NanoPenguin/hydrabus-usb-c/hardware/HydraBus_1_0_Rev1_4_Kicad_USBC/HydraBus.kicad_pcb

## KiCad design hardware/HydraBus_1_0_Rev1_4_Kicad_USBC/HydraBus.kicad_pcb (2023-07-11)

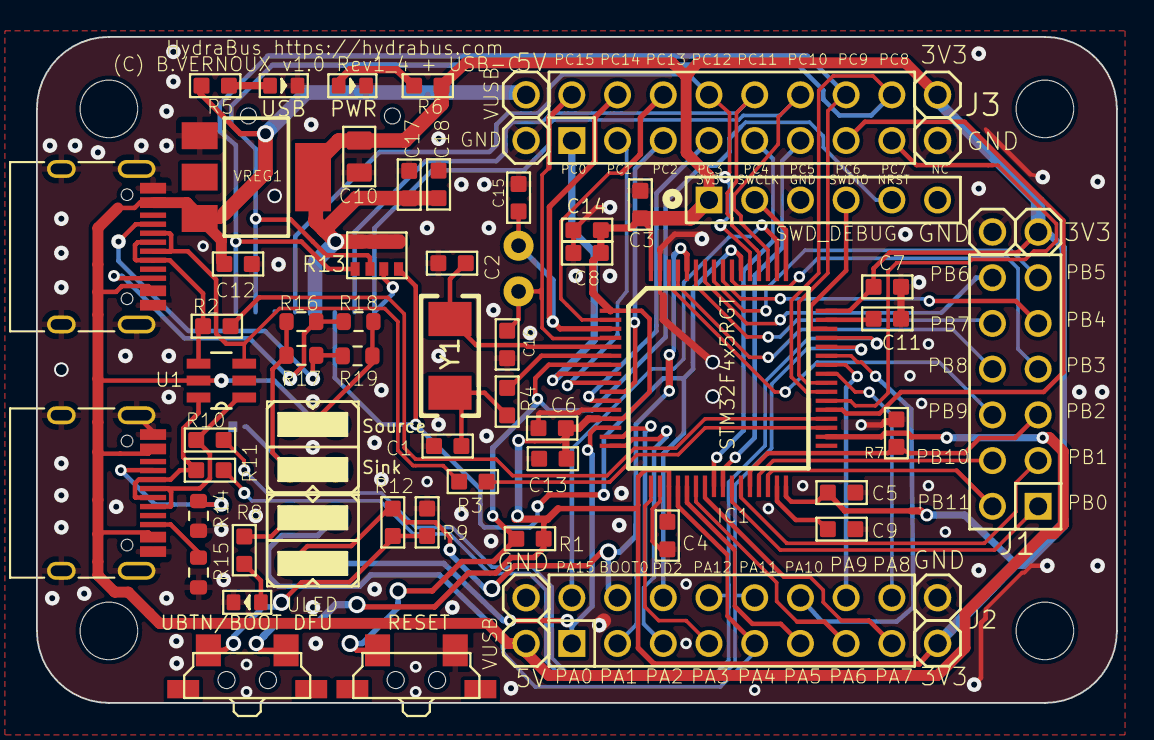
[picture p2: board HydraBus.kicad_pcb from above]

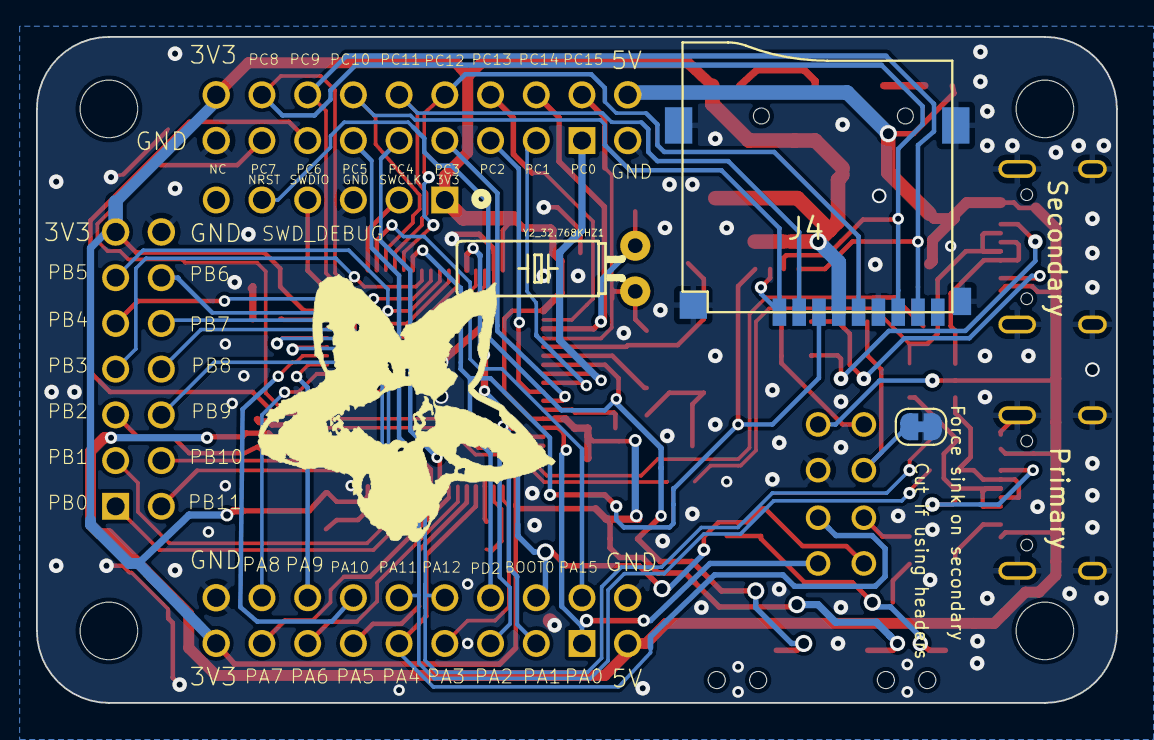
[picture p3: board HydraBus.kicad_pcb from below]

Board: 2 copper layers, 60.0 x 37.0 mm, 72 parts (3 on the bottom side), 72 nets.

Parts:
C1, C2: 18pF; C0603
C3, C4, C5, C6, C7, C8, C12, C18: 100nF; C0603
C9, C11, C13, C17: 2.2uF; C0603
C10: 10uF; C0805
C14: 4.7uF; C0603
C15, C16: 8pF; C0603
DP6037_V1: DP6037_V1
IC1: STM32F4x5RGT; LQFP64
J1: CON_HEADER_2X06; M2X6
J2, J3: CON_HEADER_2X08; M2X8
J4: MICRO-SDCARD-CONNECTOR-3300060P1; 9P-SMD-W-RING
J5: CON_HEADER_1X06-PTH; M1X6
J6, J7: USB_C_Receptacle_USB2.0; USB_C_Receptacle_HRO_TYPE-C-31-M-12
JMP1, JMP2: JP2QE; JP2Q
JMP_UBTN1, JMP_UBTN2: SHORT-JUMPER-2P-3460440P1; 2P-2.54
JMP_ULED1, JMP_ULED2: SHORT-JUMPER-2P-3460440P1; 2P-2.54
JP1, JP4: 5V; 1X01
JP2, JP3, JP6, JP8, JP10: GND; 1X01
JP5: SolderJumper_2_Bridged; SolderJumper-2_P1.3mm_Bridged_RoundedPad1.0x1.5mm
JP7, JP9, JP11: 3V3; 1X01
PWR1: LED; LED0603
R1, R7, R9, R12: 10K; R0603
R2, R3, R10, R11: 22; R0603
R4: 220; R0603
R5: 3.3K; R0603
R6, R8: 2.2K; R0603
R13: 10K; R1206-8
R14, R15, R16, R17: 5.1K; R_0603_1608Metric
R18, R19: 56K; R_0603_1608Metric
RESET1: BUTTON-2P-REINFORCE-3100060P1; 4P-SMD-7.0X3.5X3.5H-90D
U1: IP4220CZ6; SOT95P275X110-6N
UBTN1: BUTTON-2P-REINFORCE-3100060P1; 4P-SMD-7.0X3.5X3.5H-90D
ULED1: LED; LED0603
USB3: LED; LED0603
VREG1: LD1117AS33TR; SOT223
Y1: SMD-5032_2P_8MHz_20ppm_20pF; SMD-5032_2P
Y2_32.768KHZ1: 32.768KHz; TC38H

Connections:
+3V3: C3.1, C4.1, C5.2, C6.1, C7.1, C8.1, C10.1, C13.1, C14.1, C17.2, C18.1, IC1.1 (VBAT), IC1.13 (VDDA), IC1.19 (VDD@19), IC1.32 (VDD@32), IC1.48 (VDD@48), IC1.64 (VDD@64), J4.4 (VDD), J5.1, JP7.1, JP9.1, JP11.1, R1.2, R6.2, R13.5 (2), R13.6 (2), R13.7 (2), R13.8 (2), UBTN1.2, VREG1.4 (OUT)
/BOOT0: IC1.60 (BOOT0), J2.4, JMP1.4 (2), R12.2
/NRST: IC1.7 (NRST), J5.5, R1.1, RESET1.1
/PA0: IC1.14 (PA0), J2.1, JMP1.3 (1)
/PA1: IC1.15 (PA1), J2.3
/PA2: IC1.16 (PA2), J2.5
/PA3: IC1.17 (PA3), J2.7
/PA4: IC1.20 (PA4), J2.9, JMP1.1
/PA5: IC1.21 (PA5), J2.11
/PA6: IC1.22 (PA6), J2.13
/PA7: IC1.23 (PA7), J2.15
/PA8: IC1.41 (PA8), J2.16
/PA9: IC1.42 (PA9), J2.14
/PA10: IC1.43 (PA10), J2.12
/PA15: IC1.50 (PA15), J2.2
/PB0: IC1.26 (PB0), J1.1
/PB1: IC1.27 (PB1), J1.3
/PB2: IC1.28 (PB2), J1.5, R7.1
/PB3: IC1.55 (PB3), J1.7
/PB4: IC1.56 (PB4), J1.9
/PB5: IC1.57 (PB5), J1.11
/PB6: IC1.58 (PB6), J1.12
/PB7: IC1.59 (PB7), J1.10
/PB8: IC1.61 (PB8), J1.8
/PB9: IC1.62 (PB9), J1.6
/PB10: IC1.29 (PB10), J1.4
/PB11: IC1.30 (PB11), J1.2
/PC0: IC1.8 (PC0), J3.1
/PC1: IC1.9 (PC1), J3.3
/PC2: IC1.10 (PC2), J3.5
/PC3: IC1.11 (PC3), J3.7
/PC4: IC1.24 (PC4), J3.9
/PC5: IC1.25 (PC5), J3.11
/PC6: IC1.37 (PC6), J3.13
/PC7: IC1.38 (PC7), J3.15
/PC8: IC1.39 (PC8), J3.16, J4.7 (DO), R13.2 (1)
/PC9: IC1.40 (PC9), J3.14, J4.8 (DATA1), R13.1
/PC10: IC1.51 (PC10), J3.12, J4.1 (DATA2), R13.3 (1)
/PC11: IC1.52 (PC11), J3.10, J4.2 (CS)
/PC12: IC1.53 (PC12), J3.8, J4.5 (SCLK)
/PC13: IC1.2 (PC13), J3.6
/PC14: C15.1, IC1.3 (PC14), J3.4, Y2_32.768KHZ1.2
/PC15: C16.1, IC1.4 (PC15), J3.2, Y2_32.768KHZ1.1
/PD2: IC1.54 (PD2), J2.6, J4.3 (DI), R13.4 (1)
/PH0: C2.1, IC1.5 (PH0), Y1.1 (OSC1)
/PH1: IC1.6 (PH1), R4.2
/SWD_SWCLK: IC1.49 (PA14), J5.2
/SWD_SWDIO: IC1.46 (PA13), J5.4
/USB0D_N: IC1.44 (PA11), J2.10, R11.2
/USB0D_P: IC1.45 (PA12), J2.8, R10.2
/USB1D_N: IC1.35 (PB14), R3.2
/USB1D_P: IC1.36 (PB15), R2.2
/VCAP_1: C9.2, IC1.31 (VCAP_1)
/VCAP_2: C11.1, IC1.47 (VCAP_2)
GND: C1.2, C2.2, C3.2, C4.2, C5.1, C6.2, C7.2, C8.2, C9.1, C10.2, C11.2, C12.2, C13.2, C14.2, C15.2, C16.2, C17.1, C18.2, IC1.12 (VSSA), IC1.18 (VSS@18), IC1.63 (VSS@63), J4.6 (VSS), J4.G1, J4.G2, J4.G3, J4.G4, J5.3, J6.A1 (GND), J6.A12 (GND), J6.B1 (GND), J6.B12 (GND), J6.S1 (SHIELD), J7.A1 (GND), J7.A12 (GND), J7.B1 (GND), J7.B12 (GND), J7.S1 (SHIELD), JMP2.2, JP2.1, JP3.1, JP5.2 (B), JP6.1, JP8.1, JP10.1, PWR1.-, R7.2, R9.2, R14.2, R15.2, RESET1.2, U1.2 (GND), ULED1.-, USB3.-, VREG1.1 (ADJ)
unnamed: J6.A5 (CC1), R14.1
unnamed: J6.B5 (CC2), R15.1
unnamed: JMP1.2, R8.2
unnamed: JMP2.3 (1), R18.2, R19.2
unnamed: JMP2.1, JP5.1 (A), R16.2, R17.2
unnamed: PWR1.+, R6.1
unnamed: R5.2, USB3.+
unnamed: R8.1, ULED1.+
unnamed: R9.1, R12.1, UBTN1.1
unnamed: C1.1, R4.1, Y1.2 (OSC2)
SUPPLY_VUSB: C12.1, IC1.34 (PB13), J6.A4 (VBUS), J6.A9 (VBUS), J6.B4 (VBUS), J6.B9 (VBUS), J7.A4 (VBUS), J7.A9 (VBUS), J7.B4 (VBUS), J7.B9 (VBUS), JMP2.4 (2), JP1.1, JP4.1, R5.1, U1.5 (VP), VREG1.3 (IN)
USB0_D+: J6.A6 (D+), J6.B6 (D+), R10.1, U1.1 (I/O_4)
USB0_D-: J6.A7 (D-), J6.B7 (D-), R11.1, U1.6 (I/O_2)
USB1_CC1: J7.A5 (CC1), R17.1, R19.1
USB1_CC2: J7.B5 (CC2), R16.1, R18.1
USB1_D+: J7.A6 (D+), J7.B6 (D+), R2.1, U1.4 (I/O_3)
USB1_D-: J7.A7 (D-), J7.B7 (D-), R3.1, U1.3 (I/O)
